Zclarkwilliams/Drone2_LS_Capstone/Source-Code/testing_files/i2c_sim/README.txt

Simulates I2C read transactions without using EFB and IMU.

Writes to I2C are discarded. Reads are given values from a data array. 

This module allows testing of higher level modules and forcing data from IMU.
