Zclarkwilliams/Drone2_LS_Capstone/Source-Code/testing_files/verify_FPGA_IMU_with_Arduino/README.txt

These files were used to connect the FPGA and IMU together with an Arduno.
Selected data from the IMU is printed out on the Arduino serial console and can be validated.
