Zclarkwilliams/Drone2_LS_Capstone/Source-Code/testing_files/calibration_restore/README.txt

These files were used to verify that calibration restore would work. They are tweaked versions of the Adafruit library files.
