Zclarkwilliams/Drone2_LS_Capstone/Source-Code/testing_files/verify_FPGA_IMU_with_Arduino/IMU Data Ranges - Waiving Around.xlsx

X Rot Vel | Y Rot Vel | Z Rot Vel | X Euler | Y Euler | Z Euler | Calibration |  | X Rot Vel | Y Rot Vel | Z Rot Vel | X Euler | Y Euler | Z Euler | Calibration
0.69 | 0.12 | -0.25 | -0.88 | 3.56 | 187.69 | 247 | Max | 2032.38 | 2033.69 | 1645.13 | 86.12 | 179.69 | 359.88 | 255
2 | 0.56 | -0.06 | -0.88 | 3.31 | 188.13 | 247 | Min | -1988.75 | -1882.19 | -1197.88 | -84.75 | -179.81 | 0 | 0
148.63 | -2.81 | 5.75 | -1.37 | -11.5 | 185.13 | 247
20.56 | 22.69 | 11.25 | -2.31 | -20 | 188.63 | 247
34 | 21.94 | -15.44 | -3.31 | -23.19 | 189.5 | 247
16.56 | 31.75 | 42.44 | -5.75 | -26.37 | 187.13 | 247
20.69 | -15.75 | 2.75 | -2.88 | -24.56 | 185.13 | 247
20.37 | -6.31 | 0.56 | -1.63 | -27 | 184 | 247
34.31 | -2.94 | -12.06 | -1.19 | -28.44 | 185 | 247
-15.44 | 5 | 8.5 | -1.63 | -28.62 | 185.69 | 247
11.63 | -0.37 | -0.81 | -1.63 | -27.87 | 184.75 | 247
-5.38 | 4.69 | -0.75 | -1.81 | -28.06 | 185.06 | 247
3.19 | -0.25 | -4.13 | -2 | -28.06 | 185.31 | 247
-2.44 | -0.37 | -1.31 | -2.06 | -28.62 | 185.63 | 247
-1.12 | 1.44 | -0.06 | -2.13 | -28.44 | 185.75 | 247
-5.25 | -0.5 | 0.06 | -2.19 | -28.69 | 185.56 | 247
1.88 | 1.31 | -0.12 | -2.19 | -28.87 | 185.56 | 247
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
