Zclarkwilliams/Drone2_LS_Capstone/(threads)

Thread 33 (2018-05-12):

Account for how pitch is interpreted by the receiver in the motor_mixer

bcreeley, 2018-05-12:
Description:
    * The receiver outputs 1ms when pitch is pushed all the way forward.
    * The receiver outputs 2ms when pitch is pulled all the way backward.
    * This needs to be accounted for in the motor_mixer module to make sure the correct motors are
       spinning based on this.

bcreeley, 2018-05-13:
This is a non-issue and we have determined that everything is working correctly.

Closed 2018-05-13.

Thread 36 (2018-05-12):

In IMU change from rotational acceleration to rotational velocity (gyro rate)

bcreeley, 2018-05-12:
Currently the IMU module is outputting rotational acceleration (degrees/second^2), but we need the data to be in rotational velocity (degrees/second).

bcreeley, 2018-05-13:
This change has been made by Ethan and the changes are merged into master, but we have not done any testing so keeping this open until we find value ranges and perform some testing with the updates.

bcreeley, 2018-05-25:
Closing this as completed.

Closed 2018-05-25.

Thread 39 (2018-05-12):

8 onboard debug LEDs are a pain in the ass to change

bcreeley, 2018-05-12:
It's a pain to change the onboard debug LEDs every time we want them connected to something different, so provide a fix by using all of the onboard flip switches.  I think it would be confusing to allow them to be 16 different values so make it work for 4 different values (1 for each pin) and default to something in case its an invalid flip switch configuration.

Example:

1111 - IMU Calibration (Normal all flip switches up)
1110 - Reset
0111 - Receiver throttle value
1011 - ???
0111 - ???
default - Imu debug output

bcreeley, 2018-05-13:
A fix has been created in the drone2.v top level module for this.

Closed 2018-05-13.

Thread 41 (2018-05-12):

Determine if motor 3 bias set to -16 is correct

bcreeley, 2018-05-12:
With the receiver, angle_controller, motor_mixer, and pwm_generator the bias for motor 3 needs to be set at -16.

Closed 2018-05-25.

Thread 45 (2018-05-12):

Fix `default_nettype none declaration in common_defines.v

bcreeley, 2018-05-12:
This declaration is currently wrong in common_defines.v.  The correct declaration is:

`default_nettype none

This throws all sorts of errors in every file pretty much so this will be a cleanup TODO that needs to happen all at once.

Thread 51 (2018-05-16):

Change wire names of x/y/z_rotation and x/y/z_rotation_rate in drone2.v

bcreeley, 2018-05-16:
These wires should be renamed in drone2.v to more descriptive names, shown below.  These changes will need to be mirrored on the draw.io file "Software Block Diagram.html" once they are made to keep the documentation up to date.

roll_rotation
pitch_rotation
yaw_rotation

roll_rotation_rate
pitch_rotation_rate
yaw_rotation_rate

Zclarkwilliams, 2018-06-07:
This was updated in the flight_mode_testing branch and will be up to standards once branch is merged.

Closed 2018-06-07.

Thread 65 (2018-05-22):

Flip actual roll rate in the BFC to account for it being reversed from the IMU

bcreeley, 2018-05-22:
This is already being done in the AC so do it in the BFC as well.

bcreeley, 2018-06-02:
All of the directions are correct now.  Drone is flying stably.

Closed 2018-06-02.

Thread 69 (2018-05-23):

Fix synchronization between AC/IMU

bcreeley, 2018-05-23:

bcreeley, 2018-06-02:
This has been fixed.

Closed 2018-06-02.

Thread 70 (2018-05-24):

Make RATE_MIN and RATE_MAX in pid.v parameters instead of localparams

bcreeley, 2018-05-24:
This will allow the pitch_pid, roll_pid, yaw_pid to have different RATE_MIN and RATE_MAX bounds without having to change anything else.

bcreeley, 2018-05-25:
This has been fixed and merged into master.

Closed 2018-05-25.

Thread 101 (2018-06-02):

Determine why we had to flip x/y_rotation_rates from IMU into the BFC

bcreeley, 2018-06-02:
Roll is considered the y-axis for the AC and Pitch is considered the x-axis for the AC.  In the BFC this is flipped.

Thread 105 (2018-06-04):

Increase bit width of the integer portion of the yaw values in the BFC

bcreeley, 2018-06-04:
We are having constant yaw without input from the receiver.  We increased the Kp of Yaw in the BFC to 40 and 44 and this seemed to overflow the s11.4 bit width.  This could be increased and then we could limit the output of the yaw portion of the PID to the Motor Mixer since the MM can only output a certain amount of granularity.

Zclarkwilliams, 2018-06-07:
This was fixed when we expanded out calculation bit widths to 32 bits.

Closed 2018-06-07.
