Zclarkwilliams/Drone2_LS_Capstone/Source-Code/Drone2/impl1/source/angle_controller.v

/**
 * ECE 412-413 Capstone Winter/Spring 2018
 * Team 32 Drone2 SOC
 * Ethan Grinnell,
 * Brett Creeley,
 * Daniel Christiansen,
 * Kirk Hooper,
 * Zachary Clark-Williams
 */

/**
 *  Module takes as inputs:
 *     - Target rate & angles from the receiver module
 *     - 8-bit values
 *     - The throttle represents a rate, from 0 to max (???)
 *     - The yaw is a rate, from  a negative min to a positive max
 *     - The pitch and roll represent target angles (degrees)
 *     - Actual pitch and roll angles from the IMU
 *     - Represent degrees
 *     - In 16-bit, 2's complement, 12-bits integer, 4-bits fractional
 *
 * Module provides as output (all values are 16-bit, 2's complement):
 *     - Limited throttle rate (>= 0)
 *     - Limited yaw, pitch, and roll rates
 *     - Represent degrees/second
 *
 * TODO:
 *        Rate limits???
 *        Update this header description to look like other files
 */
`timescale 1ns / 1ns

`include "common_defines.v"
`include "pid_parameters.v"

module angle_controller (
    output reg  signed [`RATE_BIT_WIDTH-1:0] throttle_rate_out,
    output reg  signed [`RATE_BIT_WIDTH-1:0] yaw_rate_out,
    output reg  signed [`RATE_BIT_WIDTH-1:0] pitch_rate_out,
    output reg  signed [`RATE_BIT_WIDTH-1:0] roll_rate_out,
    output reg  signed [`RATE_BIT_WIDTH-1:0] yaw_angle_error,
    output reg  signed [`RATE_BIT_WIDTH-1:0] pitch_angle_error,
    output reg  signed [`RATE_BIT_WIDTH-1:0] roll_angle_error,
    output reg  active_signal,
    output reg  complete_signal,
    input  wire [`REC_VAL_BIT_WIDTH-1:0] throttle_target,
    input  wire [`REC_VAL_BIT_WIDTH-1:0] pitch_target,
    input  wire [`REC_VAL_BIT_WIDTH-1:0] roll_target,
    input  wire yaac_enable_n,
    input  wire signed [`RATE_BIT_WIDTH-1:0] yaw_angle_target,
    input  wire signed [`RATE_BIT_WIDTH-1:0] yaw_angle_error_in,
    input  wire signed [`RATE_BIT_WIDTH-1:0] pitch_actual,
    input  wire signed [`RATE_BIT_WIDTH-1:0] roll_actual,
    input  wire [2:0] switch_a,
    input  wire start_signal,
    input  wire resetn,
    input  wire us_clk);

    // rate limits (16-bit, 2's complement, 12-bit integer, 4-bit fractional)
    localparam signed [`OPS_BIT_WIDTH-1:0]
        THROTTLE_MAX    =  250 << `FIXED_POINT_SHIFT,
        YAW_MAX         =  200 << `FIXED_POINT_SHIFT,
        YAW_MIN         = -200 << `FIXED_POINT_SHIFT,
        PITCH_MAX       =  200 << `FIXED_POINT_SHIFT,
        PITCH_MIN       = -200 << `FIXED_POINT_SHIFT,
        ROLL_MAX        =  200 << `FIXED_POINT_SHIFT,
        ROLL_MIN        = -200 << `FIXED_POINT_SHIFT;


    // Mapping input range to other
    localparam signed [`OPS_BIT_WIDTH-1:0]
        MAPPING_SUBS    = 500;

    // Mapping input Padding Zeros
    localparam signed
        END_PAD         = 2'b0,
        FRONT_PAD       = 6'b0,
        THROTTLE_F_PAD  = 4'b0,
        THROTTLE_R_PAD  = 4'b0;

    // working registers
    reg signed [`OPS_BIT_WIDTH-1:0]     mapped_throttle, mapped_yaw, mapped_roll, mapped_pitch;
    reg signed [`OPS_BIT_WIDTH-1:0]     scaled_throttle, scaled_yaw, scaled_roll, scaled_pitch;
    reg signed [`REC_VAL_BIT_WIDTH-1:0] latched_throttle, latched_pitch, latched_roll;
    reg signed [`RATE_BIT_WIDTH-1:0]    latched_yaw_angle_target;
    reg signed [`RATE_BIT_WIDTH-1:0]    latched_yaw_angle_error;
    reg [`OPS_BIT_WIDTH-1:0]            multiplier;

    // state names
    localparam
        STATE_WAITING  = 5'b00001,
        STATE_MAPPING  = 5'b00010,
        STATE_SCALING  = 5'b00100,
        STATE_LIMITING = 5'b01000,
        STATE_COMPLETE = 5'b10000;

    // state variables
    reg [4:0] state, next_state;

    reg start_flag = `FALSE;

    // latch start signal
    always @(posedge us_clk or negedge resetn) begin
        if(!resetn)
            start_flag     <= `FALSE;
        else if(start_signal && !start_flag)
            start_flag     <= `TRUE;
        else if(!start_signal && start_flag) begin
            if(state != STATE_WAITING)
                start_flag <= `FALSE;
        end
        else
            start_flag     <= start_flag;
    end

    // update state
    always @(posedge us_clk or negedge resetn) begin
        if(!resetn) begin
            state                    <= STATE_WAITING;
            latched_throttle         <= `ALL_ZERO_2BYTE;
            latched_yaw_angle_error  <= `ALL_ZERO_2BYTE;
            latched_pitch            <= `ALL_ZERO_2BYTE;
            latched_roll             <= `ALL_ZERO_2BYTE;
        end
        else begin
            state                    <= next_state;
            latched_yaw_angle_target <= yaw_angle_target;
            latched_yaw_angle_error  <= yaw_angle_error_in;
            latched_roll             <= roll_target;
            latched_pitch            <= pitch_target;
            latched_throttle         <= throttle_target;
        end
    end

    // next state logic
    always @(*) begin
        case(state)
            STATE_WAITING: begin
                if(start_flag)
                    next_state = STATE_MAPPING;
                else
                    next_state = STATE_WAITING;
            end
            STATE_MAPPING: begin
                next_state = STATE_SCALING;
            end
            STATE_SCALING: begin
                next_state = STATE_LIMITING;
            end
            STATE_LIMITING: begin
                next_state = STATE_COMPLETE;
            end
            STATE_COMPLETE: begin
                next_state = STATE_WAITING;
            end
            default: begin
                next_state = STATE_WAITING;
            end
        endcase
    end

    // output logic
    always @(posedge us_clk or negedge resetn) begin
        if(!resetn) begin
            // reset values
            yaw_rate_out   <= `ALL_ZERO_2BYTE;
            roll_rate_out  <= `ALL_ZERO_2BYTE;
            pitch_rate_out <= `ALL_ZERO_2BYTE;
            multiplier     <= 0;

        end
        else begin
            case(state)
                STATE_WAITING: begin
                    complete_signal         <= `FALSE;
                    active_signal           <= `FALSE;
                    if (switch_a[0])   // Acro mode pitch/roll rate  
                        multiplier <= 16'sd2;
                    else               // Easy mode pitch/roll rate  
                        multiplier <= 16'sd1;
                end
                STATE_MAPPING: begin
                    complete_signal         <= `FALSE;
                    active_signal           <= `TRUE;    
                    // Yaw Accumulator is disabled, use original yaw handling
                    // input values mapped from 0 - 250 to -31.25 - 31.25
                    if(yaac_enable_n)
                        mapped_yaw          <= $signed({FRONT_PAD, latched_yaw_angle_target[7:0], END_PAD}) - MAPPING_SUBS;
                    // Yaw Accumulator is enabled, use new yaw handling - Calculated in YAAc
                    else
                        mapped_yaw          <= latched_yaw_angle_error;
                    mapped_throttle         <= $signed({THROTTLE_F_PAD, latched_throttle, THROTTLE_R_PAD});
                    // input values mapped from 0 - 250 to -31.25 - 31.25
                    mapped_roll             <= ($signed({FRONT_PAD, latched_roll,  END_PAD}) - MAPPING_SUBS)*multiplier + roll_actual; // roll value from IMU is flipped, add instead of subtract
                    mapped_pitch            <= ($signed({FRONT_PAD, latched_pitch, END_PAD}) - MAPPING_SUBS)*multiplier - pitch_actual;
                    
                end
                STATE_SCALING: begin
                    complete_signal         <= `FALSE;
                    active_signal           <= `TRUE;
                    // Apply scaler: (axis_val * scale_multiplier) / Scale_divisor
                    if(yaac_enable_n)
                        scaled_yaw          <= scale_val(mapped_yaw, `YAW_OLD_AC_K_P, `YAW_AC_K_P_SHIFT);
                    else
                        scaled_yaw          <= scale_val(mapped_yaw, `YAW_YAAC_AC_K_P, `YAW_AC_K_P_SHIFT);
                    scaled_roll             <= scale_val(mapped_roll, `ROLL_AC_K_P, `ROLL_AC_K_P_SHIFT);
                    scaled_pitch            <= scale_val(mapped_pitch, `PITCH_AC_K_P, `PITCH_AC_K_P_SHIFT);
                    scaled_throttle         <= scale_val(mapped_throttle, `THROTTLE_AC_K_P, `THROTTLE_AC_K_P_SHIFT);
                end
                STATE_LIMITING: begin
                    complete_signal         <= `FALSE;
                    active_signal           <= `TRUE;

                    // Throttle rate limits
                    if(scaled_throttle > THROTTLE_MAX)
                        throttle_rate_out   <= THROTTLE_MAX;
                    else if(scaled_throttle < `MOTOR_VAL_MIN)
                        throttle_rate_out   <= `MOTOR_VAL_MIN;
                    else
                        throttle_rate_out   <= scaled_throttle;

                    // Yaw rate limits
                    if(scaled_yaw > YAW_MAX)
                        yaw_rate_out        <= YAW_MAX;
                    else if(scaled_yaw < YAW_MIN)
                        yaw_rate_out        <= YAW_MIN;
                    else
                        yaw_rate_out        <= scaled_yaw;

                    // Roll rate limits
                    if(scaled_roll > ROLL_MAX)
                        roll_rate_out       <= ROLL_MAX;
                    else if(scaled_roll < ROLL_MIN)
                        roll_rate_out       <= ROLL_MIN;
                    else
                        roll_rate_out       <= scaled_roll;

                    // Pitch rate limits
                    if(scaled_pitch > PITCH_MAX)
                        pitch_rate_out      <= PITCH_MAX;
                    else if(scaled_pitch < PITCH_MIN)
                        pitch_rate_out      <= PITCH_MIN;
                    else
                        pitch_rate_out      <= scaled_pitch;

                    yaw_angle_error         <= latched_yaw_angle_error;
                    pitch_angle_error       <= mapped_pitch;
                    roll_angle_error        <= mapped_roll;
                end
                STATE_COMPLETE: begin
                    complete_signal         <= `TRUE;
                    active_signal           <= `FALSE;
                end
                default: begin
                    pitch_rate_out          <= `ALL_ZERO_2BYTE;
                    yaw_rate_out            <= `ALL_ZERO_2BYTE;
                    roll_rate_out           <= `ALL_ZERO_2BYTE;
                    throttle_rate_out       <= `ALL_ZERO_2BYTE;
                end
            endcase
        end
    end

/**
 *    scale_val function is created to operate the:
 *        output = (input_value x scaling_value) / scaling_shift
 *    this mitigates intermediate register overflow.
 */
function automatic signed [`RATE_BIT_WIDTH-1:0] scale_val;
    input reg signed [`RATE_BIT_WIDTH-1:0]        val;
    input reg signed [`OPS_BIT_WIDTH-1:0]          k_mult;
    input reg signed [`SHIFT_OP_BIT_WIDTH-1:0]    k_shift;

    reg signed [31:0]
        val_32,
        scaled;

    localparam
        SHIFT_BACK = 7'd16,
        ZERO_PAD   = 16'd0;

    localparam signed [31:0]
        OVERFLOW_PROTECTION_MIN = 32'shFFFF8000,
        OVERFLOW_PROTECTION_MAX = 32'sh00007FFF;

    begin
        // cast values to the 32 bits
        val_32 = $signed({val, ZERO_PAD}) >>> SHIFT_BACK;
        // apply the scalar
        scaled = (val_32 * k_mult) >>> k_shift;

        // make sure we don't output an overflowed value
        if (scaled <= OVERFLOW_PROTECTION_MIN)
            scale_val = OVERFLOW_PROTECTION_MIN;
        else if (scaled >= OVERFLOW_PROTECTION_MAX)
            scale_val = OVERFLOW_PROTECTION_MAX;
        else
            scale_val = $signed(scaled[`RATE_BIT_WIDTH-1:0]);
    end
endfunction

endmodule
