Zclarkwilliams/Drone2_LS_Capstone/Source-Code/Drone2/impl1/source/body_frame_controller.v

/**
 * ECE 412-413 Capstone Winter/Spring 2018
 * Team 32 Drone2 SOC
 * Ethan Grinnell,
 * Brett Creeley,
 * Daniel Christiansen,
 * Kirk Hooper,
 * Zachary Clark-Williams
 */

/**
 * module body_frame_controller- top level module for rotation rate control.
 * Takes in target rotation rates and actual rotation rates and outputs control
 * values to motor mixer.
 *
 * Outputs:
 * @yaw_rate_out - yaw rate to motor mixer
 * @roll_rate_out - roll rate to motor mixer
 * @pitch_rate_out - pitch rate to motor mixer
 *
 * Inputs:
 * (target values are 2's complement, fixed-point, 12.4 bits)
 * @yaw_rate_in - target yaw rotation rate from angle controller (deg/s)
 * @roll_rate_in - target roll rate from angle controller (deg/s)
 * @pitch_rate_in - target pitch rate from angle controller (deg/s)
 *
 * (actual values are 2's complement, in 1/100ths of a degree)
 * @roll_rotation - actual roll rate from IMU (deg/s)
 * @pitch_rotation - actual pitch rate from IMU (deg/s)
 * @yaw_rotation - actual yaw rate from IMU (deg/s)
 *
 * @start_flag - signal from angle controller to  begin cycle
 * @resetn - global reset signal
 * @us_clk - 1MHz clock
 */

`timescale 1ns / 1ns
`include "common_defines.v"
`include "pid_parameters.v"

module body_frame_controller (
	output wire signed [`PID_RATE_BIT_WIDTH-1:0] yaw_rate_out,
	output wire signed [`PID_RATE_BIT_WIDTH-1:0] roll_rate_out,
	output wire signed [`PID_RATE_BIT_WIDTH-1:0] pitch_rate_out,
	output reg complete_signal,
	input wire signed [`RATE_BIT_WIDTH-1:0] 	yaw_target,
	input wire signed [`RATE_BIT_WIDTH-1:0] 	roll_target,
	input wire signed [`RATE_BIT_WIDTH-1:0] 	pitch_target,
	input wire signed [`IMU_VAL_BIT_WIDTH-1:0] 	roll_rotation,
	input wire signed [`IMU_VAL_BIT_WIDTH-1:0] 	pitch_rotation,
	input wire signed [`IMU_VAL_BIT_WIDTH-1:0] 	yaw_rotation,
	input wire signed [`RATE_BIT_WIDTH-1:0]		yaw_angle_error,
	input wire signed [`RATE_BIT_WIDTH-1:0]		roll_angle_error,
	input wire signed [`RATE_BIT_WIDTH-1:0] 	pitch_angle_error,
	input wire start_signal,
	input wire resetn,
	input wire us_clk);

	// internal wires
	wire yaw_active, roll_active, pitch_active;
	wire yaw_complete, roll_complete, pitch_complete;

	// working registers
	reg wait_flag, start_flag;
	reg signed [`RATE_BIT_WIDTH-1:0]	latched_yaw_target;
	reg signed [`RATE_BIT_WIDTH-1:0]	latched_roll_target;
	reg signed [`RATE_BIT_WIDTH-1:0]	latched_pitch_target;
	reg signed [`IMU_VAL_BIT_WIDTH-1:0] latched_yaw_rotation;
	reg signed [`IMU_VAL_BIT_WIDTH-1:0] latched_roll_rotation;
	reg signed [`IMU_VAL_BIT_WIDTH-1:0] latched_pitch_rotation;
	reg signed [`RATE_BIT_WIDTH-1:0]	latched_yaw_angle_error;
	reg signed [`RATE_BIT_WIDTH-1:0]	latched_roll_angle_error;
	reg signed [`RATE_BIT_WIDTH-1:0]	latched_pitch_angle_error;

	localparam STATE_BIT_WIDTH = 3'd4;
	// state names
	localparam
		STATE_WAITING  = 4'b0001,
		STATE_STARTING = 4'b0010,
		STATE_ACTIVE   = 4'b0100,
		STATE_COMPLETE = 4'b1000;

	// PID controller rate limiting values
	localparam signed [`OPS_BIT_WIDTH-1:0]
		ROLL_RATE_MIN  = -250 << `FIXED_POINT_SHIFT,
		ROLL_RATE_MAX  =  250 << `FIXED_POINT_SHIFT,
		PITCH_RATE_MIN = -250 << `FIXED_POINT_SHIFT,
		PITCH_RATE_MAX =  250 << `FIXED_POINT_SHIFT,
		YAW_RATE_MIN   = -250 << `FIXED_POINT_SHIFT,
		YAW_RATE_MAX   =  250 << `FIXED_POINT_SHIFT;

	// state variables
	reg [STATE_BIT_WIDTH-1:0] state, next_state;

	// latch start signal and target/actual rotational angles
	always @(posedge us_clk or negedge resetn) begin
		if(!resetn) begin
			start_flag					<= `FALSE;
			// Angle rates from the angle_controller
			latched_yaw_target			<= `ALL_ZERO_2BYTE;
			latched_roll_target			<= `ALL_ZERO_2BYTE;
			latched_pitch_target		<= `ALL_ZERO_2BYTE;
			latched_yaw_angle_error		<= `ALL_ZERO_2BYTE;
			latched_roll_angle_error	<= `ALL_ZERO_2BYTE;
			latched_pitch_angle_error	<= `ALL_ZERO_2BYTE;
			// Angle rates from the imu
			latched_yaw_rotation		<= `ALL_ZERO_2BYTE;
			latched_roll_rotation		<= `ALL_ZERO_2BYTE;
			latched_pitch_rotation		<= `ALL_ZERO_2BYTE;
		end
		else if(start_signal && !start_flag) begin
			start_flag					<= `TRUE;
			latched_yaw_target			<= yaw_target;
			latched_roll_target			<= roll_target;
			latched_pitch_target		<= pitch_target;
			latched_yaw_angle_error		<= yaw_angle_error;
			latched_roll_angle_error	<= roll_angle_error;
			latched_pitch_angle_error	<= pitch_angle_error;
			// Angle rates from the imu
			//latched_yaw_rotation		<= 'sd0;
			latched_yaw_rotation		<= -yaw_rotation;
			latched_roll_rotation		<= roll_rotation;
			latched_pitch_rotation		<= -pitch_rotation;

		end
		else if(!start_signal && start_flag) begin
			start_flag					<= `FALSE;
			latched_yaw_target	 		<= latched_yaw_target;
			latched_roll_target			<= latched_roll_target;
			latched_pitch_target		<= latched_pitch_target;
			latched_yaw_rotation		<= latched_yaw_rotation;
			latched_roll_rotation		<= latched_roll_rotation;
			latched_pitch_rotation		<= latched_pitch_rotation;
			latched_yaw_angle_error		<= latched_yaw_angle_error;
			latched_roll_angle_error	<= latched_roll_angle_error;
			latched_pitch_angle_error	<= latched_pitch_angle_error;
		end
		else begin
			start_flag					<= start_flag;
			latched_yaw_target			<= latched_yaw_target;
			latched_roll_target			<= latched_roll_target;
			latched_pitch_target		<= latched_pitch_target;
			latched_yaw_rotation		<= latched_yaw_rotation;
			latched_roll_rotation		<= latched_roll_rotation;
			latched_pitch_rotation		<= latched_pitch_rotation;
			latched_yaw_angle_error		<= latched_yaw_angle_error;
			latched_roll_angle_error	<= latched_roll_angle_error;
			latched_pitch_angle_error	<= latched_pitch_angle_error;
		end
	end

	// update state
	always @(posedge us_clk or negedge resetn) begin
		if(!resetn)
			state <= STATE_WAITING;
		else
			state <= next_state;
	end

	// next state logic
	always @(*) begin
    	if(!resetn) begin
    	  next_state = STATE_WAITING;
    	end
    	else begin
  			case (state)
  				STATE_WAITING: begin
  					if(start_flag)
  						next_state	= STATE_STARTING;
  					else
  						next_state	= STATE_WAITING;
  				end
  				STATE_STARTING: begin
  					if(yaw_active && pitch_active && roll_active)
  						next_state	= STATE_ACTIVE;
  					else
  						next_state	= STATE_STARTING;
  				end
  				STATE_ACTIVE: begin
  					if(yaw_complete && pitch_complete && roll_complete)
  						next_state	= STATE_COMPLETE;
  					else
  						next_state	= STATE_ACTIVE;
  				end
  				STATE_COMPLETE: begin
  					next_state		= STATE_WAITING;
  				end
				default: begin
				  next_state 		= STATE_WAITING;
				end
  			endcase
    	end
	end

	// sub-module control logic
	always @(state) begin
		case(state)
			STATE_WAITING: begin
				wait_flag 		<= `TRUE;
				complete_signal <= `FALSE;
			end
			STATE_STARTING: begin
				wait_flag 		<= `FALSE;
				complete_signal <= `FALSE;
			end
			STATE_ACTIVE: begin
				wait_flag 		<= `FALSE;
				complete_signal <= `FALSE;
			end
			STATE_COMPLETE: begin
				wait_flag 		<= `FALSE;
				complete_signal <= `TRUE;
			end
			default: begin
				wait_flag 		<= `TRUE;
				complete_signal <= `FALSE;
			end
		endcase
	end

	// pid instantiations
	pid #(
		.RATE_MIN(YAW_RATE_MIN),
		.RATE_MAX(YAW_RATE_MAX),
		.K_P_SHIFT(`YAW_K_P_SHIFT),
		.K_I_SHIFT(`YAW_K_I_SHIFT),
		.K_P(`YAW_K_P),
		.K_I(`YAW_K_I),
		.K_D(`YAW_K_D))
	yaw_pid (
		// Output
		.rate_out(yaw_rate_out),
		.pid_complete(yaw_complete),
		.pid_active(yaw_active),
		// Input
		.target_rotation(latched_yaw_target),
		.actual_rotation(latched_yaw_rotation),
		.angle_error(latched_yaw_angle_error),
		.start_flag(start_flag),
		.wait_flag(wait_flag),
		.resetn(resetn),
		.us_clk(us_clk));

	pid #(
		.RATE_MIN(PITCH_RATE_MIN),
		.RATE_MAX(PITCH_RATE_MAX),
		.K_P_SHIFT(`PITCH_K_P_SHIFT),
		.K_I_SHIFT(`PITCH_K_I_SHIFT),
		.K_D_SHIFT(`PITCH_K_D_SHIFT),
		.K_P(`PITCH_K_P),
		.K_I(`PITCH_K_I),
		.K_D(`PITCH_K_D))
	pitch_pid (
		// Output
		.rate_out(pitch_rate_out),
		.pid_complete(pitch_complete),
		.pid_active(pitch_active),
		// Input
		.target_rotation(latched_pitch_target),
		.actual_rotation(latched_pitch_rotation),
		.angle_error(latched_pitch_angle_error),
		.start_flag(start_flag),
		.wait_flag(wait_flag),
		.resetn(resetn),
		.us_clk(us_clk));

	pid #(
		.RATE_MIN(ROLL_RATE_MIN),
		.RATE_MAX(ROLL_RATE_MAX),
		.K_P_SHIFT(`ROLL_K_P_SHIFT),
		.K_I_SHIFT(`ROLL_K_I_SHIFT),
		.K_D_SHIFT(`ROLL_K_D_SHIFT),
		.K_P(`ROLL_K_P),
		.K_I(`ROLL_K_I),
		.K_D(`ROLL_K_D))
	roll_pid (
		// Output
		.rate_out(roll_rate_out),
		.pid_complete(roll_complete),
		.pid_active(roll_active),
		// Input
		.target_rotation(latched_roll_target),
		.actual_rotation(latched_roll_rotation),
		.angle_error(latched_roll_angle_error),
		.start_flag(start_flag),
		.wait_flag(wait_flag),
		.resetn(resetn),
		.us_clk(us_clk));

endmodule
