Zclarkwilliams/Drone2_LS_Capstone/Source-Code/Drone2/impl1/source/drone2.v

/**
 * ECE 412-413 Capstone Winter/Spring 2018
 * Team 32 Drone2 SOC
 * Ethan Grinnell,
 * Brett Creeley,
 * Daniel Christiansen,
 * Kirk Hooper,
 * Zachary Clark-Williams
 */

/**
 * drone2 - Top level module for the drone controller.
 *
 * Outputs:
 * @motor_1_pwm:  signal to drive the ESC connected to motor 1
 * @motor_2_pwm:  signal to drive the ESC connected to motor 2
 * @motor_3_pwm:  signal to drive the ESC connected to motor 3
 * @motor_4_pwm:  signal to drive the ESC connected to motor 4
 * @resetn_imu:     signal to reset IMU from FPGA
 * @led_data_out: signal mapping data to FPGA board's 8 LEDs
 *
 * Inputs:
 * @yaw_pwm:      signal from yaw on the rc/receiver
 * @roll_pwm:     signal from roll on the rc/receiver
 * @pitch_pwm:    signal from pitch on the rc/receiver
 * @throttle_pwm: signal from throttle on the rc/receiver
 * @aux1_pwm:     signal from 1(aux1) on the rc/receiver
 * @aux2_pwm:     signal from 2(aux2) on the rc/receiver
 * @swa_swb_pwm:  signal from 3(swa/swb) on the rc/receiver
 * @resetn:       top level reset signal
 * @led_data_out: connects to the on board LEDs for the MachX03
 *
 * Inouts:
 * @sda 1&2:      serial data line to the IMU
 * @scl 1&2:      serial clock line to the IMU
 */

`timescale 1ns / 1ns
//`default_nettype none
`include "common_defines.v"

module drone2 (
    // Outputs
    output wire motor_1_pwm,
    output wire motor_2_pwm,
    output wire motor_3_pwm,
    output wire motor_4_pwm,
    output wire resetn_imu,
    output reg  [7:0] led_data_out,
    output wire urf_trigger_out,
    // Inputs
    input wire throttle_pwm,
    input wire yaw_pwm,
    input wire roll_pwm,
    input wire pitch_pwm,
    input wire aux1_pwm,
    input wire aux2_pwm,
    input wire swa_swb_pwm,
    input wire machxo3_switch_reset_n,
    input wire urf_echo_in,
    // Serial IO
    inout wire sda_1,
    inout wire sda_2,
    inout wire scl_1,
    inout wire scl_2,
    
    //UART IO
    input wire sin,
    output wire rxrdy_n,
    output wire sout,
    output wire txrdy_n
    );

    //--------------- Receiver Wires --------------//
    wire [`REC_VAL_BIT_WIDTH-1:0]
        throttle_val,
        yaw_val,
        roll_val,
        pitch_val,
        aux1_val,
        aux2_val,
        swa_swb_val;
        
    //-------- Yaw Angle Accumulator Wires --------//
    wire [`RATE_BIT_WIDTH-1:0]
        yaac_yaw_angle_error,
        yaac_debug,
        yaac_yaw_angle_target;
    wire yaac_active,
        yaw_stick_out_of_neutral_window,
        yaac_complete,
        yaac_enable_n;

    //---------------- IMU Wires ------------------//
    wire [`IMU_VAL_BIT_WIDTH-1:0]
        x_rotation,
        y_rotation,
        z_rotation,
        x_rotation_rate,
        y_rotation_rate,
        z_rotation_rate,
        x_linear_accel,
        y_linear_accel,
        z_linear_accel;
    wire ac_active;
    wire imu_data_valid_monitor;
    wire imu_good;
    wire imu_data_valid;
    wire [7:0] imu_debug;
    
    //--------- Auto Mode Controller Wires --------//
    wire  [`REC_VAL_BIT_WIDTH-1:0] amc_throttle_val;
    wire  amc_active_signal;
    wire  amc_complete_signal;
    wire  [31:0] z_linear_accel_zeroed;
    wire  [31:0] amc_debug;
    wire  [`RATE_BIT_WIDTH-1:0] amc_z_linear_velocity;

    //--------- Throttle Controller Wires ---------//
    wire [`REC_VAL_BIT_WIDTH-1:0]
        tc_throttle_val;
    wire throttle_controller_complete,
        throttle_controller_active,
        tc_enable_n;
        
    //---------- Angle_Controller Wires -----------//
    wire [`RATE_BIT_WIDTH-1:0]
        throttle_target_rate,
        yaw_target_rate,
        roll_target_rate,
        pitch_target_rate,
        yaw_angle_error,
        roll_angle_error,
        pitch_angle_error;
    wire ac_valid_strobe;

    //-------- Body_Frame_Controller Wires --------//
    wire [`PID_RATE_BIT_WIDTH-1:0]
        yaw_rate,
        roll_rate,
        pitch_rate;
    wire bf_active;
    wire bf_valid_strobe;

    //------------- Motor_Mixer Wires -------------//
    wire [`MOTOR_RATE_BIT_WIDTH-1:0]
        motor_1_rate,
        motor_2_rate,
        motor_3_rate,
        motor_4_rate;

    //--------------- Clock Wires -----------------//
    wire sys_clk;
    wire us_clk;

    //---------------- Reset Wires ----------------//
    wire resetn;
    //wire soft_reset_n;
    //assign resetn = (machxo3_switch_reset_n & soft_reset_n);
    assign resetn = (machxo3_switch_reset_n);
    

    //---------------- Mode Selector Wires ----------------//
    wire [2:0] switch_a;
    wire [1:0] switch_b;
    //wire switch_a;
    //assign switch_a = swa_swb_val[6];
    
    //--------- Ultrasonic Range Finder Wires --------//
    wire  urf_active_signal;
    wire [15:0]urf_debug;
    wire [9:0] urf_range;


    /**
     * Generate System Clock
     */
    defparam OSCH_inst.NOM_FREQ = "38.00";
    OSCH OSCH_inst (
        .STDBY(1'b0),
           .OSC(sys_clk),
           .SEDSTDBY());

    /**
     * Then scale system clock down to 1 microsecond
     *        file - us_clk.v
     */
    us_clk us_clk_divider (
        .us_clk(us_clk),
        .sys_clk(sys_clk),
        .resetn(resetn));

    /**
     * Gets inputs from the physical receiver and converts them to 0-255.
     *         file - receiver.v
     */
    receiver receiver (
        // Outputs
        .throttle_val(throttle_val),
        .yaw_val(yaw_val),
        .roll_val(roll_val),
        .pitch_val(pitch_val),
        .aux1_val(aux1_val),
        .aux2_val(aux2_val),
        .swa_swb_val(swa_swb_val),
        // Inputs
        .throttle_pwm(throttle_pwm),
        .yaw_pwm(yaw_pwm),
        .roll_pwm(roll_pwm),
        .pitch_pwm(pitch_pwm),
        .aux1_pwm(aux1_pwm),
        .aux2_pwm(aux2_pwm),
        .swa_swb_pwm(swa_swb_pwm),
        .us_clk(us_clk),
        .resetn(resetn));
        
    /*
    *  Determine running flight mode from mode selector switches a and b
    */    
    flight_mode MODE(
        .swa_swb_val(swa_swb_val),
        .switch_a(switch_a),
        .switch_b(switch_b),
        .resetn(resetn),
        .us_clk(us_clk)
    );


    /**
     * IMU Management and Control Module
     *        file - bno055_driver.v
     */
    bno055_driver IMU(
        // Outputs
        .imu_good(imu_good),
        .valid_strobe(imu_data_valid),
        .gyro_rate_x(x_rotation_rate),
        .gyro_rate_y(y_rotation_rate),
        .gyro_rate_z(z_rotation_rate),
        .euler_angle_x(x_rotation),
        .euler_angle_y(y_rotation),
        .euler_angle_z(z_rotation),
        .linear_accel_x(x_linear_accel),
        .linear_accel_y(y_linear_accel),
        .linear_accel_z(z_linear_accel),
        // DEBUG WIRE
        .led_data_out(imu_debug),
        // InOuts
        .scl_1(scl_1),
        .sda_1(sda_1),
        .scl_2(scl_2),
        .sda_2(sda_2),
        // Inputs
        .resetn(resetn),
        .sys_clk(sys_clk),
        .resetn_imu(resetn_imu),
        .next_mod_active(throttle_controller_active)
    );

        
    auto_mode_controller AMC (
        .debug(amc_debug),
        .throttle_pwm_val_out(amc_throttle_val),
        .active_signal(amc_active_signal),
        .complete_signal(amc_complete_signal),
        .z_linear_accel_zeroed(z_linear_accel_zeroed),
        .z_linear_velocity(amc_z_linear_velocity),
        .imu_good(imu_good),
        .z_linear_accel(z_linear_accel),
        .throttle_pwm_val_in(throttle_val),
        .switch_a(switch_a),
        .switch_b(switch_b),
        .start_signal(imu_data_valid),
        .resetn(resetn),
        .us_clk(us_clk)
    );

     throttle_controller TC(
        .throttle_pwm_value_out(tc_throttle_val),
        .complete_signal(throttle_controller_complete),
        .active_signal(throttle_controller_active),
        .throttle_pwm_value_in(amc_throttle_val),
        //.throttle_pwm_value_in(throttle_val),
        .start_signal(amc_complete_signal),
        //.start_signal(imu_data_valid),
        .tc_enable_n(tc_enable_n),
        .switch_a(switch_a),
        .imu_good(imu_good),
        .resetn(resetn),
        .us_clk(us_clk));        
        
    /**
     *   Takes accumulated yaw PWM value to calculate the current desired
     *   yaw rotation. Uses the IMU provided yaw Euler angle to calculate an angle
     *   error from this desired body angle
     *   file - yaw_angle_accumulator.v
     */
    yaw_angle_accumulator  YAAc(
        .yaw_stick_out_of_neutral_window(yaw_stick_out_of_neutral_window),
        .body_yaw_angle_target(yaac_yaw_angle_target),
        .yaw_angle_error_out(yaac_yaw_angle_error),
        .active_signal(yaac_active),
        .complete_signal(yaac_complete),
        .throttle_pwm_value_input(tc_throttle_val),
        .yaw_pwm_value_input(yaw_val),
        .yaw_angle_imu(z_rotation),
        .yaac_enable_n(yaac_enable_n),
        .switch_a(switch_a),
        .debug_out(yaac_debug),
        .imu_good(imu_good),
        .start_signal(throttle_controller_complete),
        .resetn(resetn),
        .us_clk(us_clk)
        );

    /**
     *   Take IMU provided orientation angle and user provided target angle and
     *   subtract them to get the error angle rate to get to target angle
     *   position.
     *   file - angle_controller.v
     */
    angle_controller AC(
        // Outputs
        .throttle_rate_out(throttle_target_rate),
        .yaw_rate_out(yaw_target_rate),
        .roll_rate_out(roll_target_rate),
        .pitch_rate_out(pitch_target_rate),
        .yaw_angle_error(yaw_angle_error),
        .pitch_angle_error(pitch_angle_error),
        .roll_angle_error(roll_angle_error),
        .complete_signal(ac_valid_strobe),
        .active_signal(ac_active),
        // Inputs
        .throttle_target(tc_throttle_val),
        .yaac_enable_n(yaac_enable_n),
        .yaw_angle_target(yaac_yaw_angle_target),
        .yaw_angle_error_in(yaac_yaw_angle_error),
        .roll_target(roll_val),
        .pitch_target(pitch_val),
        .roll_actual(y_rotation),
        .pitch_actual(x_rotation),
        .switch_a(switch_a),
        .start_signal(yaac_complete),
        .resetn(resetn),
        .us_clk(us_clk));

    /**
     *   Take error rate angles from angle_controller and current rotational
     *   angle rates and feed them into a PID to get corrective control.
     *   file - body_frame_controller.v
     */
    body_frame_controller BFC(
        // Outputs
        .yaw_rate_out(yaw_rate),
        .roll_rate_out(roll_rate),
        .pitch_rate_out(pitch_rate),
        .complete_signal(bf_valid_strobe),
        // Inputs
        .yaw_target(yaw_target_rate),
        .roll_target(roll_target_rate),
        .pitch_target(pitch_target_rate),
        .roll_rotation(x_rotation_rate),
        .pitch_rotation(y_rotation_rate),
        .yaw_rotation(z_rotation_rate),
        .yaw_angle_error(yaw_angle_error),
        .roll_angle_error(roll_angle_error),
        .pitch_angle_error(pitch_angle_error),
        .start_signal(ac_valid_strobe),
        .resetn(resetn),
        .us_clk(us_clk));

    /**
     *   Get axis rates and calculate respective motor rates to achieve correct
     *   drone movements.
     *   file - motor_mixer.v
     */
    motor_mixer motor_mixer (
        // Outputs
        .motor_1_rate(motor_1_rate),
        .motor_2_rate(motor_2_rate),
        .motor_3_rate(motor_3_rate),
        .motor_4_rate(motor_4_rate),
        // Inputs
        .throttle_rate(throttle_target_rate),
        .yaw_rate(yaw_rate),
        .roll_rate(roll_rate),
        .pitch_rate(pitch_rate),
        .sys_clk(sys_clk),
        .resetn(resetn));

    /**
     *   Take respective motor rate outputs from motor mixer and convert the
     *   0-250 value to a PWM output to ESCs.
     *   file - pwm_generator.v
     */
    pwm_generator pwm_generator (
        // Outputs
        .motor_1_pwm(motor_1_pwm),
        .motor_2_pwm(motor_2_pwm),
        .motor_3_pwm(motor_3_pwm),
        .motor_4_pwm(motor_4_pwm),
        // Inputs
        .motor_1_rate(motor_1_rate),
        .motor_2_rate(motor_2_rate),
        .motor_3_rate(motor_3_rate),
        .motor_4_rate(motor_4_rate),
        .us_clk(us_clk),
        .resetn(resetn));
        
    ultrasonic_range_finder URF (
        .urf_range(urf_range),
        .active_signal(urf_active_signal),
        .urf_trigger_out(urf_trigger_out),
        .urf_debug(urf_debug),
        .urf_echo_in(urf_echo_in),
        .resetn(resetn),
        .us_clk(us_clk)
    );
        
        
    uart_top uart
    (
        .resetn(resetn),
        .clk(sys_clk),
        .start(imu_data_valid),
        .sin(sin),
        .rxrdy_n(rxrdy_n),
        .sout(sout),
        .txrdy_n(txrdy_n),

        .imu_x_rotation_angle(x_rotation),
        .imu_y_rotation_angle(y_rotation),
        .imu_z_rotation_angle(z_rotation),
        .imu_x_rotation_rate(x_rotation_rate),
        .imu_y_rotation_rate(y_rotation_rate),
        .imu_z_rotation_rate(z_rotation_rate),
        .imu_calibration_status(imu_debug),
        .rec_throttle_val(throttle_val),
        .rec_yaw_val(yaw_val),
        .rec_roll_val(roll_val),
        .rec_pitch_val(pitch_val),
        .rec_aux1_val(aux1_val),
        .rec_aux2_val(aux2_val),
        //.rec_swa_swb_val(swa_swb_val),
        .rec_swa_swb_val(z_linear_accel),
        //.yaac_yaw_angle_error(yaac_yaw_angle_error),
        .yaac_yaw_angle_error(z_linear_accel_zeroed[31:16]),
        //.yaac_yaw_angle_target(yaac_yaw_angle_target),
        .yaac_yaw_angle_target(z_linear_accel_zeroed[31:16]),
        .amc_z_linear_velocity(amc_z_linear_velocity),
        .debug_17_in_16_bits(urf_debug[15:0]),
        //.debug_17_in_16_bits(amc_debug[15:0]),
        //.debug_17_in_16_bits({8'd0,amc_throttle_val}),
        //.debug_17_in_16_bits(yaw_rate),
        .debug_18_in_16_bits({6'd0,urf_range})
        //.debug_18_in_16_bits({8'd0,tc_throttle_val})
        //.debug_18_in_16_bits({11'd0, switch_b, switch_a})

    );
    // Enable bits
    assign yaac_enable_n = `LOW_ACTIVE_ENABLE;  // Enable YAAC
    assign tc_enable_n   = `LOW_ACTIVE_ENABLE;  // Enable TC
    //assign tc_enable_n   = `LOW_ACTIVE_DISABLE; // Disable TC
    //assign soft_reset_n  = `LOW_ACTIVE_DISABLE; // Disable this reset for now, connect if soft reset is needed and remove this line
        
    /**
     * The section below is for use with Debug LEDs
     */

    // Update on board LEDs, all inputs are active low
    always @(posedge sys_clk) begin
        if (!resetn) begin
            led_data_out <= 8'hAA;
        end
        else begin
            led_data_out <= ~imu_debug;
        end
    end
endmodule
