Zclarkwilliams/Drone2_LS_Capstone/Source-Code/Drone2/impl1/source/txmitt.v

//   ==================================================================
//   >>>>>>>>>>>>>>>>>>>>>>> COPYRIGHT NOTICE <<<<<<<<<<<<<<<<<<<<<<<<<
//   ------------------------------------------------------------------
//   Copyright (c) 2013 by Lattice Semiconductor Corporation
//   ALL RIGHTS RESERVED 
//   ------------------------------------------------------------------
//
//   Permission:
//
//      Lattice SG Pte. Ltd. grants permission to use this code
//      pursuant to the terms of the Lattice Reference Design License Agreement. 
//
//
//   Disclaimer:
//
//      This VHDL or Verilog source code is intended as a design reference
//      which illustrates how these types of functions can be implemented.
//      It is the user's responsibility to verify their design for
//      consistency and functionality through the use of formal
//      verification methods.  Lattice provides no warranty
//      regarding the use or functionality of this code.
//
//   --------------------------------------------------------------------
//
//                  Lattice SG Pte. Ltd.
//                  101 Thomson Road, United Square #07-02 
//                  Singapore 307591
//
//
//                  TEL: 1-800-Lattice (USA and Canada)
//                       +65-6631-2000 (Singapore)
//                       +1-503-268-8001 (other locations)
//
//                  web: http://www.latticesemi.com/
//                  email: techsupport@latticesemi.com
//
//   --------------------------------------------------------------------
//
// --------------------------------------------------------------------
// Code Revision History :
// --------------------------------------------------------------------
// Ver: | Author |Mod. Date |Changes Made:
// V1.0 |        |          | Initial ver
// V1.1 | S.R.   |18/12/08  | modified to support Mico8
// --------------------------------------------------------------------

`ifndef TXMITT_FILE
`define TXMITT_FILE
`timescale 1ns/10ps
//`include "system_conf.v"
module txmitt #(parameter DATAWIDTH = 16,
                parameter FIFO = 0) 
  (  
  reset,         // Global reset and clock
  clk,      
  thr,           // Register THR                    
  thr_wr,        // THR write strobe 
  sout,          // Transmitter output              
  databits,      // Transmitter control             
  stopbits,      
  parity_en,     
  parity_even,   
  parity_stick,  
  tx_break,      
  thre,          // Transmitter status  
  temt,
  fifo_empty_thr,
  thr_rd,
  divisor);

  input    reset ;
  input    clk   ;
  input [DATAWIDTH-1 :0]   thr;
                 
  input                    thr_wr ;
  input [1:0]              databits;
  input [1:0]              stopbits;
  input                    parity_en;
  input                    parity_even ;
  input                    parity_stick; 
  input                    tx_break ;
  input                    fifo_empty_thr;
  output                   thr_rd;
                 
  output                   thre;
  output                   temt;
  output                   sout;
  input [15:0]             divisor;
  
  reg                      tx_output;
  reg [DATAWIDTH-1 :0]     tsr;
  reg                      tx_parity;
  reg                      thr_empty;
  reg                      tsr_empty;
  reg                      tx_in_start_s;
  reg                      tx_in_shift_s;
  reg                      tx_in_stop_s;
  reg                      tx_in_shift_s1; //tx_in_shift_s delayed 1 clock
  reg                      tx_in_stop_s1; //tx_in_stop_s delayed 1 clock
  reg                      txclk_ena;
  reg                      txclk_enb;
  reg [2:0]                tx_cnt;
  reg [3:0]                count_v;
  reg                      thr_rd_int = 1'd0;
  reg                      thr_rd_delay = 1'd0;
  reg                      last_word;
  
  // State Machine Definition
  localparam start        = 3'b000;
  localparam shift        = 3'b001;
  localparam parity       = 3'b010;
  localparam stop_1bit    = 3'b011;
  localparam stop_2bit    = 3'b100;
  localparam stop_halfbit = 3'b101;
  localparam start1       = 3'b110; 
 
  reg [2:0] tx_state;
  reg [15:0] counter;
  wire [15:0] divisor_2;
  assign divisor_2 = divisor/2;

 generate 
   if (FIFO == 1)  
   // Generate Single cycle THR FIFO read signal 
   always @(posedge clk or posedge reset)
     if (reset)
       thr_rd_delay <= 1'b0;
     else
       thr_rd_delay <= thr_rd_int;
   assign thr_rd = thr_rd_int & ~thr_rd_delay; 	     
 endgenerate

   ////////////////////////////////////////////////////////////////////////////////
   // Transmitter Finite State Machine
   ////////////////////////////////////////////////////////////////////////////////

   generate
   begin
      if (FIFO == 1)
      begin

     always @(posedge clk or posedge reset) begin
     if (reset) 
       thr_rd_int <= 1'b0;
     else begin
       if ((tx_state == start) && (!fifo_empty_thr) && !thr_rd_int)
         thr_rd_int <= 1'b1;
       else if (tx_state == shift)
	 thr_rd_int <= 1'b0;      
     end
     end

     always @(posedge clk or posedge reset) begin
     if (reset) begin
          tx_cnt    <= 0;
          tsr       <= 0;
          tx_output <= 1'b1;
          tx_parity <= 1'b1;
          tx_state  <= start; 
          last_word <= 1'b0;
          counter   <= 16'b0000000000000000;end 
     else begin
        case (tx_state)

  start:  
	if (thr_rd_delay)   
	  tx_state <= start1;
	  
  start1: begin
             if (last_word)
		  last_word <= 1'b0;
            if ( ~|counter)
	      counter <= divisor;
            else begin
	      if (counter == 16'b0000_0000_0000_0001) begin
		 counter <= 0;
	         tx_state <= shift;
                 tx_parity <= ~parity_even;  // TxParity initialization
                 tx_cnt <= 0;		
		 tsr <= thr;
	      end
              else
	        counter <= counter - 1'b1;
	     end
              tx_output <= 1'b0;	
         end

	 shift: begin
	     tx_output <= tsr[0];	 
	     if ( ~|counter)
	      counter <= divisor;
             else begin
	      if (counter == 16'b0000_0000_0000_0001) begin
		tx_parity <= tx_parity ^ tsr[0];
		counter <= 0;      
                tsr <= {1'b0, tsr[7:1]};      // Shift serial data out
                tx_cnt <= tx_cnt + 1;
                if ((databits==2'b00 && tx_cnt==3'h4) || 
                    (databits==2'b01 && tx_cnt==3'h5) || 
                    (databits==2'b10 && tx_cnt==3'h6) || 
                    (databits==2'b11 && tx_cnt==3'h7))   
                    tx_state <= (parity_en) ? parity : stop_1bit;
                end
	      else 
	        counter <= counter - 1'b1;
             end
           end 	     
	  parity: begin
            if ( ~|counter)
	      counter <= divisor;
             else begin
	      if (counter == 16'b0000_0000_0000_0001) begin
		counter <= 0;
                tx_state <= stop_1bit;
              end
	      else
		counter <= counter - 1'b1;
             end
             tx_output <= (parity_stick) ? (~parity_even) : tx_parity;
           end 	     
              
	   stop_1bit: begin
             if ( ~|counter)
	      counter <= divisor;
             else begin
	      if (counter == 16'b0000_0000_0000_0001) begin
		counter <= 0; 
                if (fifo_empty_thr)
	          last_word <= 1'b1;
                if (stopbits == 2'b00)      // 1 stop bit 
		   tx_state <= start; 	   
                else if (stopbits == 2'b01) // 1.5 stop bits(for 5-bit data only)
                   tx_state <= stop_halfbit;
                else
                   tx_state <= stop_2bit;    // 2 stop bits(for 6,7,8-bit data)
              end
	      else
		counter <= counter - 1'b1;
             end 	
             tx_output  <= 1'b1;
           end		   
   
	   stop_2bit: begin
             if ( ~|counter)
	      counter <= divisor;
             else begin
	      if (counter == 16'b0000_0000_0000_0001) begin
		counter <= 0;
                tx_state <= start;
	      end
              else
	        counter <= counter - 1'b1;
             end
              tx_output <= 1'b1;	     
           end		   
          
	   stop_halfbit: begin
             if ( ~|counter)
	      counter <= divisor_2;
             else begin
	      if (counter == 16'b0000_0000_0000_0001) begin
		counter <= 0;           		   
                tx_state <= start;
	      end
              else
	        counter <= counter - 1'b1;
             end
              tx_output <= 1'b1;	     
           end          
          default: tx_state <= start;
        endcase             
     end
   end
      end
      else
      begin

   always @(posedge clk or posedge reset) begin
     if (reset) begin
          tx_cnt    <= 0;
          tsr       <= 0;
          tx_output <= 1'b1;
          tx_parity <= 1'b1;
          tx_state  <= start; 
          counter   <= 16'b0000000000000000; end 
     else begin
        case (tx_state)
         start: 
            if (!thr_empty)
              tx_state <= start1;

         start1: begin 
            if ( ~|counter)
	      counter <= divisor;
            else begin
	      if (counter == 16'b0000_0000_0000_0001) begin
		 counter <= 0;
	         tx_state <= shift;
                 tx_parity <= ~parity_even;  // TxParity initialization
                 tx_cnt <= 0;		
		 tsr <= thr;
	      end
              else
	        counter <= counter - 1'b1;
	     end
              tx_output <= 1'b0;
         end

          shift: begin
	     tx_output <= tsr[0];	 
	     if ( ~|counter)
	      counter <= divisor;
             else begin
	      if (counter == 16'b0000_0000_0000_0001) begin
		tx_parity <= tx_parity ^ tsr[0];      
		counter <= 0;      
                tsr <= {1'b0, tsr[7:1]};      // Shift serial data out
                tx_cnt <= tx_cnt + 3'd1;
                if ((databits==2'b00 && tx_cnt==3'h4) || 
                    (databits==2'b01 && tx_cnt==3'h5) || 
                    (databits==2'b10 && tx_cnt==3'h6) || 
                    (databits==2'b11 && tx_cnt==3'h7))   
                    tx_state <= (parity_en) ? parity : stop_1bit;
                end
	      else 
	        counter <= counter - 1'b1;
             end
           end 
          
          parity:begin
            if ( ~|counter)
	      counter <= divisor;
             else begin
	      if (counter == 16'b0000_0000_0000_0001) begin
		counter <= 0;
                tx_state <= stop_1bit;
              end
	      else
		counter <= counter - 1'b1;
             end
             tx_output <= (parity_stick) ? (~parity_even) : tx_parity;
           end

          stop_1bit: begin
             if ( ~|counter)
	      counter <= divisor;
             else begin
	      if (counter == 16'b0000_0000_0000_0001) begin
		counter <= 0; 
                if (stopbits == 2'b00)      // 1 stop bit 
		   tx_state <= start; 	   
                else if (stopbits == 2'b01) // 1.5 stop bits(for 5-bit data only)
                   tx_state <= stop_halfbit;
                else
                   tx_state <= stop_2bit;    // 2 stop bits(for 6,7,8-bit data)
              end
	      else
		counter <= counter - 1'b1;
             end 	
             tx_output  <= 1'b1;
           end

          stop_2bit: begin
             if ( ~|counter)
	      counter <= divisor;
             else begin
	      if (counter == 16'b0000_0000_0000_0001) begin
		counter <= 0;
                tx_state <= start;
	      end
              else
	        counter <= counter - 1'b1;
             end
              tx_output <= 1'b1;	     
           end
          
          stop_halfbit:begin
             if ( ~|counter)
	      counter <= divisor_2;
             else begin
	      if (counter == 16'b0000_0000_0000_0001) begin
		counter <= 0;           		   
                tx_state <= start;
	      end
              else
	        counter <= counter - 1'b1;
             end
              tx_output <= 1'b1;	     
           end

          default: tx_state <= start;
        endcase             
     end
   end         
      end
   end
endgenerate



   ////////////////////////////////////////////////////////////////////////////////
   // Generate tsr_empty and thr_empty signals
   ////////////////////////////////////////////////////////////////////////////////

   // tsr_empty : will be set whenever tsr is empty
generate 
begin
   if (FIFO == 1)
   begin
       always @(posedge clk or posedge reset) begin 
        if (reset)
          tsr_empty <= 1'b1;
        else if (tx_in_stop_s == 1'b0 && tx_in_stop_s1 == 1'b1 && last_word) 
          tsr_empty <= 1'b1; // Set TsrEmpty flag to '1' when StopBit(s) is all transmitted 
        else if (tx_in_shift_s == 1'b1 && tx_in_shift_s1 == 1'b0)
          tsr_empty <= 1'b0; //Reset TsrEmpty flag to '0' when data is transferred from THR to TSR
     end  
   end
   else
   begin
         always @(posedge clk or posedge reset) begin 
        if (reset)
          tsr_empty <= 1'b1;		
        else if (tx_in_stop_s == 1'b0 && tx_in_stop_s1 == 1'b1)
          tsr_empty <= 1'b1; // Set TsrEmpty flag to '1' when StopBit(s) is all transmitted 
        else if (tx_in_shift_s == 1'b1 && tx_in_shift_s1 == 1'b0)
          tsr_empty <= 1'b0; //Reset TsrEmpty flag to '0' when data is transferred from THR to TSR
     end
   end
end
endgenerate


   
generate
if (FIFO == 1)
begin
    always @(posedge clk or posedge reset) begin 
     if (reset)
       thr_empty <= 1'b1;
     else if (thr_wr)
       thr_empty <= 1'b0; // Reset ThrEmpty flag to '0' when data is written into THR by CPU   
     else if (fifo_empty_thr && tx_in_shift_s && !tx_in_shift_s1) // Set ThrEmpty flag to '1' THR FIFO is empty	     	     
       thr_empty <= 1'b1;      
     end  
end
else
begin
      always @(posedge clk or posedge reset) begin 
     if (reset)
       thr_empty <= 1'b1;
     else if (thr_wr)
       thr_empty <= 1'b0; // Reset ThrEmpty flag to '0' when data is written into THR by CPU   	     
     else if (tx_in_shift_s && !tx_in_shift_s1) // Set ThrEmpty flag to '1' when data is transferred from THR to TSR 	     
       thr_empty <= 1'b1;      
     end
end
      
endgenerate


   
   
   ////////////////////////////////////////////////////////////////////////////////
          // Delayed signals for edge detections
   ////////////////////////////////////////////////////////////////////////////////
   always @(posedge clk or posedge reset) begin
        if (reset) begin
          tx_in_shift_s1 <= 1'b0;
          tx_in_stop_s1  <= 1'b0;
          end          
        else begin
          tx_in_shift_s1 <= tx_in_shift_s;
          tx_in_stop_s1  <= tx_in_stop_s;
          end
     end
   
   ////////////////////////////////////////////////////////////////////////////////
   // Transmitter FSM state indication signals
   ////////////////////////////////////////////////////////////////////////////////
   
   // tx_in_shift_s : will be set whenever transmitter is in shift state
   always @(posedge clk or posedge reset) begin 
        if (reset)
          tx_in_shift_s <= 1'b0;
        else if (tx_state == shift)
          tx_in_shift_s <= 1'b1;
        else
          tx_in_shift_s <= 1'b0;
     end
   
   // tx_in_stop_s : will be set whenever transmitter is in stop_1bit state
   always @(posedge clk or posedge reset) begin 
        if (reset)
          tx_in_stop_s <= 1'b0;
        else if (tx_state == stop_1bit)
          tx_in_stop_s <= 1'b1;
        else
          tx_in_stop_s <= 1'b0;
     end   
   
 ////////////////////////////////////////////////////////////////////////////////
 // Generate thre/temt flags
 ////////////////////////////////////////////////////////////////////////////////
 
 // Transmitter Holding Register Empty Indicator
 assign thre = thr_empty;
 
 // Transmitter Empty Indicator is set to '1' whenever thr and tsr are
 // both empty, and reset to '0' when either thr or tsr contain a character
 assign temt =((thr_empty==1'b1) && (tsr_empty==1'b1)) ?  1'b1 : 1'b0;
 
 // Serial Data Output
 // If Break Control bit is set to 1, the serial output is forced to Zero
 assign sout = (tx_break==1'b1) ? 1'b0 : tx_output;
   
endmodule
`endif // TXMITT_FILE
