Zclarkwilliams/Drone2_LS_Capstone/(commit log)

2017-12-23 Add data sheets for sensors that we already have
    Added a data sheet for the gyro/accel module, the compass module,
    and the barometric pressure sensor module.
2017-12-23 Added Verilog quick reference and reordered Tutorials folder
    Added a Reference-Material/Verilog directory to store any good Verilog
    reference materials.
    Also removed the pdf folder under Tutorials/LatticeDiamond/pdf to
    Tutorials/LatticeDiamond.
2018-01-01 Attached pin assignment file
2018-01-06 Moving previous teams work into its own directory under Reference-Material
    Moved the following files to Reference-Material/Previous-Teams-Work
    Drone_SOC_Capstone_Report_Final.pdf
    Transcript of Conversation with Casey.txt
    drone project prior team verilog backups.zip
    drone project prior team.zip
2018-01-08 Bosch BNO055 sensor operation in Arduino
2018-01-10 Initial "wire" diagram for the existing CX-20 setup
    This is still a work in progress, but it is mostly done.
    Still need to determine what some wires are and add
    names and team info to the document.
2018-01-11 Update CX-20 high level wiring diagram and organize
    Made revision 0.2 of the CX-20 high level wiring diagram and
    moved the receiver characterization document under the Documentation
    directory.
2018-01-18 Work in progress I2C wrapper for OpenCores WISHBONE library
2018-01-22 Add MachXO3 folder for Lattice Semiconductor documentation
    This is where we can store documentation on how to use/program the
    MachXO3 dev board. Add any good stuff here so we don't have to constantly
    look it up.
2018-01-29 Initial commit of our top level verilog files
    This commit also has a basic setup for a project that will
    hopefully be able to be shared across machines.
    Also we can review this and base our style on how I have done
    it here along with any comments people have.
    The contents in each file (i.e. always@ blocks) is only there
    so when synthesis is run it doesn't optimize the entired design
    out. These will be removed once the code has been merged into
    master. It also serves as a good test when people pull this code
    and try to open it as a new project under Lattice Diamond.
    [drone2.v, pid.v, pwm_generator.v, receiver.v, test_drone2.v, test_pid.v, test_pwm_generator.v, test_receiver.v]
2018-01-29 Fix the top level definition of sda/sdl to be inout's
    [drone2.v]
2018-01-30 This is a macro file to setup the traces in Active-HDL
2018-02-23 Tested connecting receiver and pwm_generator back to back
    TODO: Pull this down on my Windows box and make sure it compiles/synthesizes
    after all of the style/name changes. Functionally nothing has changed
    (except maybe the test files), but I still need to make sure everything
    compiles.
    This patch contains all of the code implemented to perform back to
    back connections between the receiver and pwm_generator. This allowed
    for inputting pwm signals and then turning that into an 8-bit value, which
    is sent to the pwm generator to generate 4 pwm signals to output to each
    ESC/motor.
    Some minor changes were made to all of these modules for this patch and
    they included:
    - Chang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
2018-03-06 Port bno055 driver to drone2 platform
2018-03-07 added explicit wire declarations
2018-03-26 Adding second i2c port
2018-04-01 Testing IMU data, crude Arduino program. Very laggy, but works... more or less
2018-04-09 Add secondary i2c functionality and fix Euler data sequence
    [bno055_defines.v, bno055_driver.v, common_defines.v, drone2.v, i2c_module_defines.v, i2c_module_top-SIM.v, i2c_module_top.v]
2018-04-09 Corrected LED View Index in IMU code
    [bno055_driver.v]
2018-04-21 ignore tcr file, changed IMU reset to pull-up mode
2018-04-21 update gitignore again, added pin assignment lpf file to git
2018-05-04 Spell my name correctly
    [bno055_defines.v, bno055_driver.v, i2c_module_defines.v, i2c_module_top-SIM.v, i2c_module_top.v, pwm_generator_block.v]
2018-05-05 changed top level instantiation of motor_mixer
2018-05-05 changed state encodings for pwm_generator_block state machine
2018-05-05 Fix compile error and make things signed
    [motor_mixer.v]
2018-05-05 changed motor mixer bounds checking
2018-05-06 Miscellaneous Cleanup
    - Removed extra new lines (1 new line between code is enough)
    - Fixed some indenting
    - Removed TODO comments that have been done
    [angle_controller.v, bno055_defines.v, bno055_driver.v, body_frame_controller.v, common_defines.v, drone2.v, i2c_module_defines.v, i2c_module_top-SIM.v]
2018-05-06 Add description for led_data_out in header comment
2018-05-06 Added reset latch to pwm generator
    [angle_controller.v, pwm_generator.v, pwm_generator_block.v]
2018-05-06 wrote rough draft of body frame controller
2018-05-06 Revert reset_latch in pwm_generator for now
    For some reason this was not outputting a minimum pwm signal
    that was expected (1000us). Need to revisit this.
    [pwm_generator.v, pwm_generator_block.v]
2018-05-07 Minimally tested and working angle controller
    This commit makes the following connection:
    receiver->angle_controller->motor_mixer->pwm_generator
    Minimal testing was done while moving the joysticks on the
    remote controller and monitoring the output of the pwm generator
    for all 4 motors.
    It seems a couple of the motors are reversed so this needs to be
    changed.
    [angle_controller.v, common_defines.v, drone2.v]
2018-05-07 Adding secondary i2c for Arduino debug
    Ignoring drone2.ldf
    update gitignore
    Testing send of data to Arduino
    debugging
    Still working on getting data to Arduino without breaking the IMU code
    More work on i2c to slave Arduino, almost functional
    Data write to Arduino functional
    Send data to Arduino working
    Testing IMU data, crude Arduino program. less laggy now, it works... more or less
    Fixed Euler angle values order
    Initial commit, convert send test data to calibration profile restore
    Fixed syntax error, no begin and end on if/else
    Calibration restore functional, need to comment code
    gitignore copied from master
    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
    [bno055_defines.v, bno055_driver.v, drone2.v, i2c_module_top-SIM.v, i2c_module_top.v, test_bno055_driver.v, test_drone2.v]
2018-05-11 added files for ESC firmware update
    [AVRDudeFav.cfg, AVRDudeProg.cfg, BLHeliSuite.cfg, ESC.cfg, ESCMotorSetup.cfg, Governor SiLabs.xls, SavedDirs.cfg, SerialPortSettings.cfg]
2018-05-12 Fix incorrect states in motor_mixer
    [motor_mixer.v]
2018-05-12 Rename files for linux happiness/ocd
    [AVRDudeFav.cfg, AVRDudeProg.cfg, BLHeliSuite.cfg, ESC.cfg, ESCMotorSetup.cfg, Governor SiLabs.xls, SavedDirs.cfg, SerialPortSettings.cfg]
2018-05-12 Make onboard debug leds work for more things
    Use the flip switches to enable multiple debug output choices
    to the onboard debug leds.
    This needs to be tested still and the following are the current
    uses.
    reset - 1110 (flip switch position)
    display receiver throttle output - 0111 (flip switch position)
    display imu debug output - default (all other flip switch positions)
    [drone2.v]
2018-05-12 Updated motor 3 bias to -16
    Motor 3 was off by ~16us, added bias to correct
    LDF updated to exlude motor_rate_calculator
    LPF updated to add 2nd switch assignment
    Currently using AC -> MM
    [common_defines.v, drone2.v]
2018-05-12 Remove esc fw package stuff for now
    [AVRDudeFav.cfg, AVRDudeProg.cfg, BLHeliSuite.cfg, ESC.cfg, ESCMotorSetup.cfg, Governor SiLabs.xls, SavedDirs.cfg, SerialPortSettings.cfg]
2018-05-12 various changes made to integrate imu & ac
2018-05-13 Corrected rotation rate to velocity instead of acceleration
    Also added I2C #2 wires back
    [angle_controller.v, bno055_driver.v, drone2.v]
2018-05-13 IMU working, doing stuff, but not validated correct
    Issue: IMU doesn't work right after watchdog event, need to TS
    [drone2.v]
2018-05-13 First step in buffering old IMU data and converting strobe to valid bit
    Valid bit will stay on unless that data from the IMU isn't valid. For now this is a single clock cycle as new data is being latched into the output buffer. Eventually this will also look at the system calibration to determine if the data being received is worth keeping
2018-05-13 Data withheld when IMU loses calibration.
2018-05-13 Update pin assignmentes for receiver with cleaned up wires
    Aileron/Roll - D9
    Elevator/Pitch - A10
    Throttle - F7
    Rudder/Yaw - B9
2018-05-15 Update pin assignmentes for receiver with cleaned up wires
    modified: Source-Code/Drone2/Drone2.lpf
    modified: Source-Code/Drone2/impl1/source/common_defines.v
    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
2018-05-17 Move MachXO3 folder from Documentation to Reference-Material
2018-05-17 Revert "Remove wikiFiles/ directory from the GitHub code repository"
    This reverts commit 4e3dbf029eca0bceaa104bd47c4cf938b8d63596.
    [restore_offsets.ino]
2018-05-17 Revert "Data withheld when IMU loses calibration."
    This reverts commit bdd300ce382a9254908bc7e993b75063ec92b40d.
    [bno055_driver.v, drone2.v, i2c_module_top-SIM.v, test_bno055_driver.v]
2018-05-17 Revert "First step in buffering old IMU data and converting strobe to valid bit"
    This reverts commit 3d97f99a03c673a309f6f9a7610f1b6ef7d77fcf.
    [bno055_driver.v, drone2.v]
2018-05-17 Revert "Corrected rotation rate to velocity instead of acceleration"
    This reverts commit 901c7ec535dec3c30ebbddb73aba82a446145f3d.
    [angle_controller.v, bno055_driver.v, drone2.v]
2018-05-17 Revert "IMU working, doing stuff, but not validated correct"
    This reverts commit 138b1b577ac312da831318391b939517f33ba9b2.
    [drone2.v]
2018-05-18 updated motor_mixer biases and throttle valid check
2018-05-18 iontegrated bfc module, added DEBUG LEDs, and cleaned up some warnings
2018-05-18 correct DEBUG_LED pins and reset_n switches
2018-05-18 Change motor_mixer clock input back to sys_clk
2018-05-20 Update the pin assignments to match the current configuration
    Updated the following input pins:
    restn_imu -> E14
    motor_1_pwm -> J15
    motor_2_pwm -> E15
    motor_3_pwm -> F16
    motor_4_pwm -> H14
2018-05-21 fixed bfc debug wire warning and motor biases
    [body_frame_controller.v, common_defines.v]
2018-05-22 add aux1,2,swa/b inputs and decode to top level and rec. modules and pin list
2018-05-23 Update most recent motor_X_pwm pins in Drone2.lpf
2018-05-23 test reverting rev1 and rev2
    [angle_controller.v, drone2.v]
2018-05-23 Inverted IMU data valid strobe
    [bno055_driver.v]
2018-05-23 Changed IMU valid to handshaked signal with AC
2018-05-23 removed motor bias, ac scalers to *8 >>> 4
2018-05-24 Remove flipping imu_debug_out internal to the bno055_driver
    This makes it so in assigning the onboard LEDs we will have to flip
    it. This matches how we do it for other values because the LEDs
    are active low.
    [bno055_driver.v]
2018-05-25 Make RATE_MIN and RATE_MAX paramters into the pid module
    This will allow different pid controllers to have different
    RATE_MIN and RATE_MAX limiters. Currently all pid modules are
    forced to use the localparam value.
2018-05-25 Fix how motor_mixer is multiplying by -1
    Prevoiusly the motor_mixer was multiplying by -1 by inverting
    value and then adding 1. This is an issue because we are sending
    the motor_mixer s11.4 values so we only want to multiply the integer
    portion by -1 and keep the decimal portion intact. Do this by
    the following method:
    new = {((~old[15:4]) + 1'b1), old[3:0]};
    [motor_mixer.v]
2018-05-25 Fixed tick defined constants in BFC
    [body_frame_controller.v, test_bno055_driver.v]
2018-05-26 Update BFC and PID parameters to be even more configurable
    Some of these parameters were changed in a previous commit,
    but I will still call them out here for completeness. The
    following are parameters added to pid.v so each axis (roll,
    yaw, pitch) can be tuned seperately:
    K_P, K_I, K_D,
    K_P_SHIFT, K_I_SHIFT, K_D_SHIFT,
    IMU_SCALAR
    K_P, K_I, K_D are the multipliers for their respective PID term and
    K_P_SHIFT, K_I_SHIFT, and K_D_SHIFT are the shift (divisor) for their
    respective pid term. This allows us to create a tunable constant.
    In the body_frame_controller each pid (yaw_pid, roll_pid, pitch_pid)
    can be instantiated with different values in all of these categories.
2018-05-26 Revert "Make latched values signed in the AC"
    This reverts commit 7d2c0bac6d6c3c19d5c98193b5253763e4ed5b01.
    [angle_controller.v]
2018-05-26 Fix comment in AC about flipped pitch (should be roll)
    [angle_controller.v]
2018-05-26 Flip roll_rotation (from IMU) in BFC
    [body_frame_controller.v]
2018-05-27 Fix MM bit meddling back to original method
    [motor_mixer.v]
2018-05-27 Change which bits we are sending to the pwm_generator from the MM
    This was working correctly before but it seemed to be confusing.
    Previously we were scaling the throttle input down in the AC from
    0-250 to 0-62.5. This then gets scaled back up in the MM by taking
    bits 9:2 before sending to the pwm_generator. This commit cleans
    this up a bit and makes it so we aren't taking 6 integer bits and
    2 decimal bits from the MM to give to the pwm_generator.
    [angle_controller.v, common_defines.v, motor_mixer.v]
2018-05-29 Moved set external crystal to after calibration restore
    Resequence and renumber actual state values to FSM sequence. The process had to change when calibration restore was introduced, but the states weren't renumbered and put in the correct order in the defines file.
    [bno055_defines.v]
2018-05-29 Fix all title blocks to match coding standards
    [angle_controller.v, bno055_defines.v, bno055_driver.v, body_frame_controller.v, common_defines.v, drone2.v, i2c_module_defines.v, i2c_module_top.v]
2018-05-29 motor_mixer output bopundary check now signed MIN and MAX
2018-05-29 Swapped Kd tern previous and current error values
    [pid.v]
2018-05-29 Fix assignment under multiple edges AC/BFC
    We were getting a warning using the start_signal as an edge
    triggered signal. Some how this was causing multiplication
    by random values (i.e. 2) not work on the drone. Removing
    the start_signal from the list seemingly fixes this issue.
    [angle_controller.v, body_frame_controller.v]
2018-05-29 Add debug IMU back to LEDs
2018-05-30 60ms WD and 10S recovery timer
2018-05-31 20ms IMU polling interval
2018-05-31 fixed parameters passed from bfc to pid
    [body_frame_controller.v, drone2.v, pid.v]
2018-05-31 flipped all rotation rates from imu
    [body_frame_controller.v, drone2.v]
2018-05-31 Fixed alignment, changed shift values, remove imu limiting
    Left a comment that says we might want to limit IMU input
    into the BFC, but limiting the output of the BFC should be
    more than enough. Also this makes it so we aren't losing
    data from the IMU by limiting it.
    [body_frame_controller.v, pid.v]
2018-05-31 Add TODO comments to determine difference in AC/BFC IMU inputs
2018-06-04 3.3v CMOS and Pull UP on IMU RSTN
2018-06-04 Revert "Continue module cleanup so all of the modules are formatted similarly"
    [angle_controller.v, bno055_driver.v, drone2.v, i2c_module_top.v, pid.v, pwm_generator.v, pwm_generator_block.v, receiver.v]
2018-06-04 Fixed comments to conform with team standard
    [bno055_driver.v]
2018-06-05 fix PID limits
2018-06-05 fixed pid boundaries to account for 4 decimal bits 250->4000
    [body_frame_controller.v]
2018-06-05 add motor_1_temp[3] to motor output for roundup
2018-06-05 tested each module for correct functionality with cleaned up internals
    [angle_controller.v, bno055_driver.v, body_frame_controller.v, common_defines.v, drone2.v, motor_mixer.v, pid.v, pwm_generator.v]
2018-06-07 update AC yaw P
2018-06-07 fixed front padding bit width to make 32bits instead of 34
    [angle_controller.v]
2018-06-10 Remove debug wire and ^M
2018-06-12 made pid 32 bit mult and shift to function
2018-06-14 Add pid parameters file for AC and BFC
2018-06-14 added scale_val function to ac and pid
2018-06-14 Fix indentation in AC and remove trailing some whitespace
    [angle_controller.v, body_frame_controller.v]
2018-06-15 Fix whitespace and inconsistent spacing everywhere
    [angle_controller.v, bno055_defines.v, bno055_driver.v, body_frame_controller.v, common_defines.v, drone2.v, i2c_module_defines.v, i2c_module_top.v]
2018-06-19 Didn't wire this module in to drone2
    [drone2.v]
2018-06-22 Piecewise linear throttle scale
2018-06-24 Fixed overflow and parameterized buffer size
    [drone2.v]
2018-06-25 Adjusting to get rid of yaw/throttle relationship
    Found that while yawing the drone would lose elevation. Adjusting PID parameters to compensate, so far, no luck. Unrelated, also renamed throttle_change_limiter to throttle_controller as it is no longer just a change limiter
    [body_frame_controller.v, drone2.v, pid_parameters.v]
2018-06-28 Added more descriptive comments to the IMU and I2C code
2018-06-30 Fixing some bugs and working on TB
    [test_throttle_controller.v, throttle_controller.v]
2018-07-01 Tuning with throttle controller in place
2018-07-15 Fixed TC enable signal, and explicitly defined literals
    [throttle_controller.v]
2018-07-21 Added IMU calibration restore Enable/Disable define
    Skips calibration restore when disabled, requires manual calibration
    [bno055_defines.v, bno055_driver.v]
2018-07-21 IMU cal disable works, testing enable
2018-12-26 Missed the doubled limit in that commit
    [angle_controller.v]
2018-12-26 Yaw Accumulator and Debug UART working
    Also included Python parser for the UART output
2018-12-27 Restructured parser to have less nesting exceptions and flows logically
2018-12-30 Found a missed register for yaw_stick_neutral_value
    Also made yaw error rate and value limits optional with `defines
    [yaw_angle_accumulator.v]
2018-12-30 Added wait for IMU init state to TC, force drone on ground if IMU !ready
2018-12-31 Added IMU ready signal to YAAc also
    Enabled yaw BFC rate input and increased yaw Kp in the AC module from 4 to 8
2019-01-01 Tabs to spaces in motor mixer and Kp adjustment, YAAc works great now
2019-01-04 Initial attempt, flight_mode.v doesn't want to compile though
    [angle_controller.v, drone2.v, flight_mode.v, throttle_controller.v, uart_top.v, yaw_angle_accumulator.v]
2019-01-07 Decrease throttle sensitivity in 'Easy' mode, neutral ~160
    160 is around where the drone takes off, so this puts neutral stick at right around there and makes the throttle much less sensitive.
2019-01-10 Reduce easy mode yaw rate and simplify mode switch logic
2019-01-13 Reverse throttle acro/easy mode logic and covert tabs to spaces
    [angle_controller.v, bno055_driver.v, drone2.v, i2c_module_top.v, throttle_controller.v, yaw_angle_accumulator.v]
2019-02-17 Initial build of Auto Mode Controller - AMC
    Added debug to UART code and renamed rstn to resetn globally for consistency
    [ParseDroneTelemetry.py, angle_controller.v, auto_mode_controller.v, bno055_driver.v, drone2.v, i2c_module_top.v, throttle_controller.v, uart_top.v]
2019-06-03 Working better, still needs debugging
    Found an issue with the UART code that made 0xF not have a valid hex value
    [auto_mode_controller.v, uart_top.v]
2019-06-03 working on auto timer, not shutting off at the moment
2019-06-29 Update pin after swapping FPGA board with non-locked one
